kittennbfive/PL2303-voltage-mod/schematic_addon.pdf

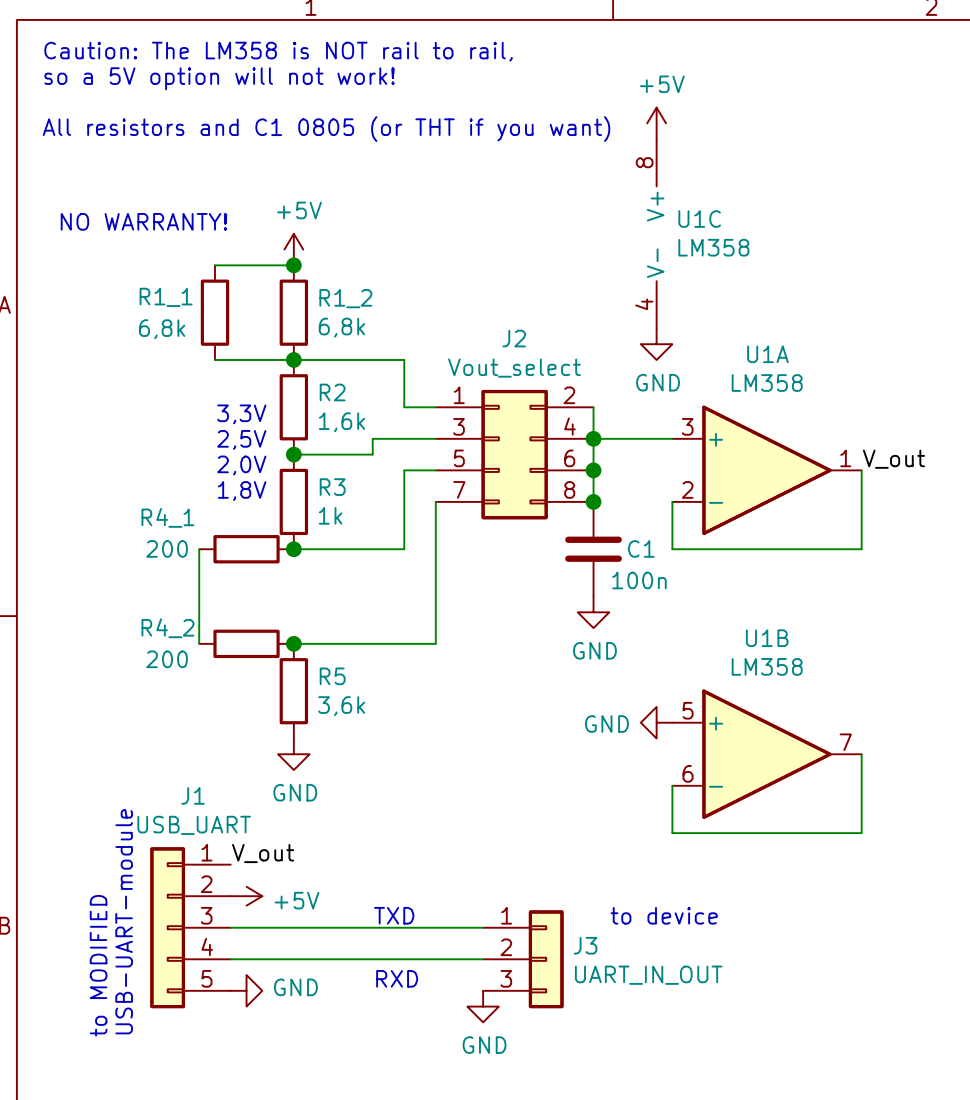
[picture p5: page 1]

to device Caution: The LM358 is NOT rail to rail, so a 5V option will not work!

All resistors and C1 0805 (or THT if you want)

PL2303-voltage-mod
(c) 2022 by kittennbfive - https://github.com/kittennbfive/

Id: 1/1 Title: File: schematic.sch Sheet: /
