kittennbfive/PL2303-voltage-mod/schematic_PL2303_module.pdf

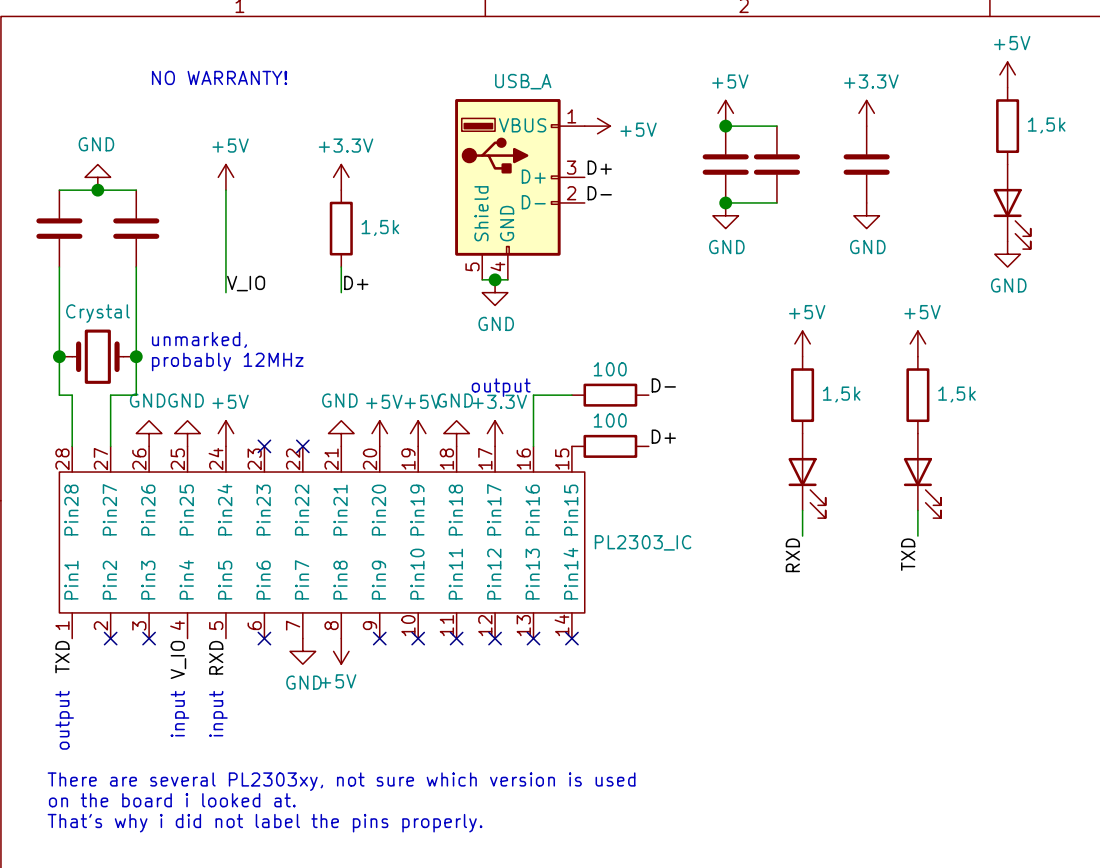
[picture p6: page 1]

unmarked, probably 12MHz NO WARRANTY!

There are several PL2303xy, not sure which version is used

reversed schematic of PL2303 USB to serial board
(c) 2022 by kittennbfive - https://github.com/kittennbfive/
