kittennbfive/PL2303-voltage-mod/schematic/schematic.sch

## KiCad design schematic/schematic.sch (2022-11-24)

Schematic: schematic.sch

Parts:
C1: 100n; C_0805_2012Metric
J1: USB_UART; PinSocket_1x05_P2.54mm_Horizontal
J2: Vout_select; PinHeader_2x04_P2.54mm_Vertical
J3: UART_IN_OUT; PinHeader_1x03_P2.54mm_Horizontal
R1_1, R1_2: 6,8k; R_0805_2012Metric
R2: 1,6k; R_0805_2012Metric
R3: 1k; R_0805_2012Metric
R4_1, R4_2: 200; R_0805_2012Metric
R5: 3,6k; R_0805_2012Metric
U1: LM358; DIP-8_W7.62mm

Notes on the sheet:
3,3V 2,5V 2,0V 1,8V
TXD
RXD
to MODIFIED USB-UART-module
to device
Caution: The LM358 is NOT rail to rail, so a 5V option will not work! All resistors and C1 0805 (or THT if you want)
PL2303-voltage-mod (c) 2022 by kittennbfive - https://github.com/kittennbfive/ CC BY-SA 4.0
NO WARRANTY!
